MouaadO/analog-pwm-generator/pcb/BOM_PCB.csv

Reference | Value | Manufacturer part number | Footprint | LTspice reference | Description
R1 | 105 | MFR-25FBF52-105R | R_Axial_DIN0207_L6.3mm_D2.5mm_P7.62mm_Horizontal | RM1
R2 | 9.76 | MBA02040C9768FC100 | R_Axial_DIN0204_L3.6mm_D1.6mm_P5.08mm_Horizontal | RMH
R3 | 9.76 | MBA02040C9768FC100 | R_Axial_DIN0204_L3.6mm_D1.6mm_P5.08mm_Horizontal | RML
R4 | 105 | MFR-25FBF52-105R | R_Axial_DIN0207_L6.3mm_D2.5mm_P7.62mm_Horizontal | RM2
R5 | 12.3k | RNF14BTC12K3 | R_Axial_DIN0207_L6.3mm_D2.5mm_P7.62mm_Horizontal | RTIM
R6 | 1k | MFR-25FBF52-1K | R_Axial_DIN0207_L6.3mm_D2.5mm_P7.62mm_Horizontal | RH1
R7 | 12k | MFR-25FBF52-12K | R_Axial_DIN0207_L6.3mm_D2.5mm_P7.62mm_Horizontal | RH2
R8 | 1.8k | MFR-25FBF52-1K8 | R_Axial_DIN0207_L6.3mm_D2.5mm_P7.62mm_Horizontal | RPO
R9 | 9.76k | MFR-25FBF52-9K76 | R_Axial_DIN0207_L6.3mm_D2.5mm_P7.62mm_Horizontal | RCM1
R10 | 1k | MFR-25FBF52-1K | R_Axial_DIN0207_L6.3mm_D2.5mm_P7.62mm_Horizontal | RCM2
R11 | 1k | MFR-25FBF52-1K | R_Axial_DIN0207_L6.3mm_D2.5mm_P7.62mm_Horizontal | RL_C
R12 | 60.4k | MFR-25FRF52-60K4 | R_Axial_DIN0207_L6.3mm_D2.5mm_P7.62mm_Horizontal | RL_DT
R13 | 1k | MFR-25FBF52-1K | R_Axial_DIN0207_L6.3mm_D2.5mm_P7.62mm_Horizontal | RH_C
R14 | 60.4k | MFR-25FRF52-60K4 | R_Axial_DIN0207_L6.3mm_D2.5mm_P7.62mm_Horizontal | RH_DT
R15 | 1.8k | MFR-25FBF52-1K8 | R_Axial_DIN0207_L6.3mm_D2.5mm_P7.62mm_Horizontal | RPA
R16 | 1.8k | MFR-25FBF52-1K8 | R_Axial_DIN0207_L6.3mm_D2.5mm_P7.62mm_Horizontal | RPB
C1 | 22u/16V | MCGPR16V226M5X11 | CP_Radial_D5.0mm_P2.00mm | CIN
C2 | 4.7u/50V | EEU-FC1H4R7H | CP_Radial_D5.0mm_P2.50mm | COUT
C3 | 2.4n C0G 1% | C317C242F3G5TA | C317_5.08mm | CINT
C4 | 100n | K104K15X7RF5TL2 | Vishay_K15_P2.5mm | CU1
C5 | 100n | K104K15X7RF5TL2 | Vishay_K15_P2.5mm | CU2
C6 | 100n | K104K15X7RF5TL2 | Vishay_K15_P2.5mm | CU3
C7 | 100n | K104K15X7RF5TL2 | Vishay_K15_P2.5mm | CU5
U1 | TLC072CP | TLC072CP | DIP-8_W7.62mm | U1A/U1B
U2 | LM319N/NOPB | LM319N/NOPB | DIP-14_W7.62mm | OSC/PA
U3 | LM319N/NOPB | LM319N/NOPB | DIP-14_W7.62mm | PB/END_HIGH
U4 | LF50ABV | LF50ABV | TO-220-3_Vertical | REG
U5 | SN74ACT240N | SN74ACT240N | DIP-20_W7.62mm | U5A/U5C/U5D
D1 | BAT85S-TR | BAT85S-TR | D_DO-35_SOD27_P7.62mm_Horizontal | END_DIODE
RV1 | 1k DUTY | PTV09A-2020F-B102 | Bourns_PTV09A2_20mm | PD
RV2 | 50k FREQ | PTV09A-2015F-B503 | Bourns_PTV09A2 | PF
RV3 | Dual 1k DEAD TIME | PTN16-A01220K1B2 | SameSky_PTN16_A_Dual | PDT_L/PDT_H
J1 | 7-10V DC, CENTRE + | PJ-102AH | BarrelJack_CUI_PJ-102AH_Horizontal | VINPUT | DC input included in current purchasing BOM; 7-10 V, centre positive
J2 | EXTERNAL DUTY | BU-1420701236 | Mueller_BU1420701236 | VEXT
J3 | MANUAL / EXTERNAL | PPTC031LFBN-RC | PinSocket_1x03_P2.54mm_Vertical | JSEL | Male jumper wire 1-2 manual, 2-3 external
J4 | DIGITAL 10 / OUT | PPTC101LFBN-RC | PinSocket_1x10_P2.54mm_Vertical | JHDR10 | UNO order SCL,SDA,AREF,GND,D13,D12,D11,D10,D9,D8
J5 | DIGITAL 8 | PPTC081LFBN-RC | PinSocket_1x08_P2.54mm_Vertical | JHDR8A | UNO D7..D0; unused
J6 | POWER | PPTC081LFBN-RC | PinSocket_1x08_P2.54mm_Vertical | JHDR8B | UNO order NC,IOREF,RESET,3V3,5V,GND,GND,VIN; no USB/Arduino backfeed protection
J7 | ANALOG 6 | PPTC061LFBN-RC | PinSocket_1x06_P2.54mm_Vertical | JHDR6 | UNO A0..A5; unused
