MouaadO/analog-pwm-generator/upload_002.xlsx

Sheet: Components
ANALOG PWM · COMPONENT PURCHASE COSTS
French VAT | 20% |  | TOTAL INCLUDING TAX |  | €31.81
Component type | Supplier part number | Component part number | Unit price (including tax) | Quantity | Total price (including tax) | Online retailer
Dual op amp · DIP-8 | 3005151 | TLC072CP | €3.6240 | 1 | €3.62 | Farnell ↗ (https://fr.farnell.com/texas-instruments/tlc072cp/ic-op-amp-hi-speed-rrio/dp/3005151)
Dual comparator · DIP-14 | LM319NNS/NOPB-ND | LM319N/NOPB | €2.6400 | 2 | €5.28 | DigiKey ↗ (https://www.digikey.fr/fr/products/detail/texas-instruments/LM319N-NOPB/9551)
Octal inverter · DIP-20 | 595-SN74ACT240N | SN74ACT240N | €1.7160 | 1 | €1.72 | Mouser ↗ (https://www.mouser.fr/en/ProductDetail/Texas-Instruments/SN74ACT240N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)
5 V LDO · ±1% at 25°C · TO-220 | 3130160 | LF50ABV | €1.3440 | 1 | €1.34 | Farnell ↗ (https://fr.farnell.com/stmicroelectronics/lf50abv/ldo-fixe-5v-0-5a-40-a-125-c/dp/3130160)
105 Ω resistor · 1% · 0.25 W axial | 603-MFR-25FBF52-105R | MFR-25FBF52-105R | €0.1032 | 2 | €0.21 | Mouser ↗ (https://www.mouser.fr/fr/ProductDetail/YAGEO/MFR-25FBF52-105R?qs=oAGoVhmvjhx1xjvQjhBaqA%3D%3D)
9.76 Ω resistor · 1% · axial | 594-5063JD9.761% | MBA02040C9768FC100 | €1.0944 | 2 | €2.19 | Mouser ↗ (https://www.mouser.fr/en/ProductDetail/Vishay-Beyschlag/MBA02040C9768FC100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)
12.3 kΩ resistor · 0.1% · 0.25 W axial | 708-RNF14BTC12K3 | RNF14BTC12K3 | €0.1656 | 1 | €0.17 | Mouser ↗ (https://www.mouser.fr/en/ProductDetail/SEI-Stackpole/RNF14BTC12K3?qs=LnCj936TGbUaYoq1Wc%2FTVQ%3D%3D)
1 kΩ resistor · 1% · 0.25 W axial | 603-MFR-25FBF52-1K | MFR-25FBF52-1K | €0.1032 | 4 | €0.41 | Mouser ↗ (https://www.mouser.fr/fr/ProductDetail/YAGEO/MFR-25FBF52-1K?qs=oAGoVhmvjhwCAC47ReWjsQ%3D%3D)
12 kΩ resistor · 1% · 0.25 W axial | MFR-25FBF52-12K-ND | MFR-25FBF52-12K | €0.1080 | 1 | €0.11 | DigiKey ↗ (https://www.digikey.fr/en/products/detail/yageo/MFR-25FBF52-12K/9138051)
1.8 kΩ resistor · 1% · 0.25 W axial | 603-MFR-25FBF52-1K8 | MFR-25FBF52-1K8 | €0.1032 | 3 | €0.31 | Mouser ↗ (https://www.mouser.fr/ProductDetail/YAGEO/MFR-25FBF52-1K8?qs=oAGoVhmvjhxFlUUkv6aTEg%3D%3D)
9.76 kΩ resistor · 1% · 0.25 W axial | 9.76KXBK-ND | MFR-25FBF52-9K76 | €0.1080 | 1 | €0.11 | DigiKey ↗ (https://www.digikey.fr/en/products/detail/yageo/MFR-25FBF52-9K76/13217)
60.4 kΩ resistor · 1% · 0.25 W axial | 603-MFR-25FRF52-60K4 | MFR-25FRF52-60K4 | €0.1080 | 2 | €0.22 | Mouser ↗ (https://www.mouser.fr/fr/ProductDetail/YAGEO/MFR-25FRF52-60K4?qs=oAGoVhmvjhwuEJuU8%2FmJxQ%3D%3D)
22 µF capacitor · 16 V · 20% radial | 9451064 | MCGPR16V226M5X11 | €0.1158 | 1 | €0.12 | Farnell ↗ (https://fr.farnell.com/multicomp-pro/mcgpr16v226m5x11/cap-22-f-16v-20/dp/9451064)
100 nF capacitor · 50 V · X7R · 10% radial | 2860097 | K104K15X7RF5TL2 | €0.1126 | 10 | €1.13 | Farnell ↗ (https://fr.farnell.com/en-FR/vishay/k104k15x7rf5tl2/cap-0-1-f-50v-10-x7r/dp/2860097)
2.4 nF capacitor · 25 V · C0G · 1% radial | 80-C317C242F3G5TA | C317C242F3G5TA | €1.8000 | 1 | €1.80 | Mouser ↗ (https://www.mouser.fr/fr/ProductDetail/KEMET/C317C242F3G5TA)
50 kΩ linear potentiometer · single gang | 652-PTV09A-2015FB503 | PTV09A-2015F-B503 | €1.1664 | 1 | €1.17 | Mouser ↗ (https://www.mouser.fr/fr/ProductDetail/Bourns/PTV09A-2015F-B503)
1 kΩ linear potentiometer · single gang | 652-PTV09A-4225FB102 | PTV09A-4225F-B102 | €0.9180 | 1 | €0.92 | Mouser ↗ (https://www.mouser.fr/ProductDetail/Bourns/PTV09A-4225F-B102?qs=Qzws7J6gxqyeFhc0kO3Q7A%3D%3D)
1 kΩ linear potentiometer · dual gang | 179-PTN16-A01220K1B2 | PTN16-A01220K1B2 | €1.8720 | 1 | €1.87 | Mouser ↗ (https://www.mouser.fr/en/ProductDetail/Same-Sky/PTN16-A01220K1B2?qs=VJzv269c%252BPaiDuqAWK2%252BFA%3D%3D)
Schottky diode · 30 V · DO-35 axial | BAT85SCT-ND | BAT85S-TR | €0.5280 | 1 | €0.53 | DigiKey ↗ (https://www.digikey.fr/en/products/detail/vishay-general-semiconductor-diodes-division/BAT85S-TR/3104128)
3-pin selector header · 2.54 mm THT | 952-2263-ND | M20-9990345 | €0.1560 | 1 | €0.16 | DigiKey ↗ (https://www.digikey.fr/fr/products/detail/harwin-inc/M20-9990345/3728227)
2-pin selector shunt · 2.54 mm | 952-2881-ND | M7582-05 | €0.1680 | 1 | €0.17 | DigiKey ↗ (https://www.digikey.fr/en/products/detail/harwin-inc/M7582-05/3922850)
Female SMA jack · vertical THT | 4472531 | BU-1420701236 | €5.4360 | 1 | €5.44 | Farnell ↗ (https://fr.farnell.com/mueller-electric/bu-1420701236/conn-rf-sma-fem-50-ohms-pcb/dp/4472531)
4.7 µF capacitor · 50 V · 20% radial | P19662CT-ND | EEU-FC1H4R7H | €0.4320 | 1 | €0.43 | DigiKey ↗ (https://www.digikey.fr/en/products/detail/panasonic-industry/EEU-FC1H4R7H/6109560)
6-pin female header · 2.54 mm THT | S7004-ND | PPTC061LFBN-RC | €0.4920 | 1 | €0.49 | DigiKey ↗ (https://www.digikey.fr/fr/products/detail/sullins-connector-solutions/PPTC061LFBN-RC/810145)
8-pin female header · 2.54 mm THT | S7006-ND | PPTC081LFBN-RC | €0.6120 | 2 | €1.22 | DigiKey ↗ (https://www.digikey.fr/fr/products/detail/sullins-connector-solutions/PPTC081LFBN-RC/810147)
10-pin female header · 2.54 mm THT | S7008-ND | PPTC101LFBN-RC | €0.6720 | 1 | €0.67 | DigiKey ↗ (https://www.digikey.fr/fr/products/detail/sullins-connector-solutions/PPTC101LFBN-RC/810149)

Sheet: Prices
SUPPLIER QUOTATIONS · BEFORE TAX INPUTS
Component part number | Supplier part number | Unit € before tax | Retailer | Quote source | Fitted quantity | Purchase quantity | Schematic references
TLC072CP | 3005151 | €3.0200 | Farnell | Source ↗ (https://fr.farnell.com/c/semiconducteurs-circuits-integres/amplificateurs-comparateurs/amplificateurs-operationnels-aop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) | 1 | 1 | U1A, U1B
LM319N/NOPB | LM319NNS/NOPB-ND | €2.2000 | DigiKey | Source ↗ (https://www.digikey.fr/fr/products/detail/texas-instruments/LM319N-NOPB/9551) | 2 | 2 | OSC, PA; PB, END_HIGH
SN74ACT240N | 595-SN74ACT240N | €1.4300 | Mouser | Source ↗ (https://www.mouser.ie/en/ProductDetail/Texas-Instruments/SN74ACT240N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) | 1 | 1 | U5A, U5C, U5D
LF50ABV | 3130160 | €1.1200 | Farnell | Source ↗ (https://fr.farnell.com/stmicroelectronics/lf50abv/ldo-fixe-5v-0-5a-40-a-125-c/dp/3130160) | 1 | 1 | REG
MFR-25FBF52-105R | 603-MFR-25FBF52-105R | €0.0860 | Mouser | Source ↗ (https://www.mouser.fr/fr/ProductDetail/YAGEO/MFR-25FBF52-105R?qs=oAGoVhmvjhx1xjvQjhBaqA%3D%3D) | 2 | 2 | RM1, RM2
MBA02040C9768FC100 | 594-5063JD9.761% | €0.9120 | Mouser | Source ↗ (https://www.mouser.fr/en/c/passive-components/resistors/?resistance=9.76%20Ohms) | 2 | 2 | RMH, RML
RNF14BTC12K3 | 708-RNF14BTC12K3 | €0.1380 | Mouser | Source ↗ (https://www.mouser.fr/en/ProductDetail/SEI-Stackpole/RNF14BTC12K3?qs=LnCj936TGbUaYoq1Wc%2FTVQ%3D%3D) | 1 | 1 | RTIM
MFR-25FBF52-1K | 603-MFR-25FBF52-1K | €0.0860 | Mouser | Source ↗ (https://www.mouser.fr/fr/ProductDetail/YAGEO/MFR-25FBF52-1K?qs=oAGoVhmvjhwCAC47ReWjsQ%3D%3D) | 4 | 4 | RH1, RCM2, RL_C, RH_C
MFR-25FBF52-12K | MFR-25FBF52-12K-ND | €0.0900 | DigiKey | Source ↗ (https://www.digikey.fr/en/products/detail/yageo/MFR-25FBF52-12K/9138051) | 1 | 1 | RH2
MFR-25FBF52-1K8 | 603-MFR-25FBF52-1K8 | €0.0860 | Mouser | Source ↗ (https://www.mouser.fr/ProductDetail/YAGEO/MFR-25FBF52-1K8?qs=oAGoVhmvjhxFlUUkv6aTEg%3D%3D) | 3 | 3 | RPO, RPA, RPB
MFR-25FBF52-9K76 | 9.76KXBK-ND | €0.0900 | DigiKey | Source ↗ (https://www.digikey.fr/en/products/detail/yageo/MFR-25FBF52-9K76/13217) | 1 | 1 | RCM1
MFR-25FRF52-60K4 | 603-MFR-25FRF52-60K4 | €0.0900 | Mouser | Source ↗ (https://www.mouser.fr/fr/ProductDetail/YAGEO/MFR-25FRF52-60K4?qs=oAGoVhmvjhwuEJuU8%2FmJxQ%3D%3D) | 2 | 2 | RL_DT, RH_DT
MCGPR16V226M5X11 | 9451064 | €0.0965 | Farnell | Source ↗ (https://fr.farnell.com/multicomp-pro/mcgpr16v226m5x11/cap-22-f-16v-20/dp/9451064) | 1 | 1 | CIN
K104K15X7RF5TL2 | 2860097 | €0.0938 | Farnell | Source ↗ (https://fr.farnell.com/en-FR/vishay/k104k15x7rf5tl2/cap-0-1-f-50v-10-x7r/dp/2860097) | 4 | 10 | CU1, CU2, CU3, CU5
C317C242F3G5TA | 80-C317C242F3G5TA | €1.5000 | Mouser | Source ↗ (https://www.mouser.fr/fr/ProductDetail/KEMET/C317C242F3G5TA) | 1 | 1 | CINT
PTV09A-2015F-B503 | 652-PTV09A-2015FB503 | €0.9720 | Mouser | Source ↗ (https://www.mouser.fr/fr/ProductDetail/Bourns/PTV09A-2015F-B503) | 1 | 1 | PF
PTV09A-4225F-B102 | 652-PTV09A-4225FB102 | €0.7650 | Mouser | Source ↗ (https://nl.mouser.com/ProductDetail/Bourns/PTV09A-4225F-B102?qs=Qzws7J6gxqyeFhc0kO3Q7A%3D%3D) | 1 | 1 | PD
PTN16-A01220K1B2 | 179-PTN16-A01220K1B2 | €1.5600 | Mouser | Source ↗ (https://www.mouser.fr/en/ProductDetail/Same-Sky/PTN16-A01220K1B2?qs=VJzv269c%252BPaiDuqAWK2%252BFA%3D%3D) | 1 | 1 | PDT_H, PDT_L
BAT85S-TR | BAT85SCT-ND | €0.4400 | DigiKey | Source ↗ (https://www.digikey.fr/en/products/detail/vishay-general-semiconductor-diodes-division/BAT85S-TR/3104128) | 1 | 1 | END_DIODE
M20-9990345 | 952-2263-ND | €0.1300 | DigiKey | Source ↗ (https://www.digikey.fr/fr/products/detail/harwin-inc/M20-9990345/3728227) | 1 | 1 | JSEL selector header
M7582-05 | 952-2881-ND | €0.1400 | DigiKey | Source ↗ (https://www.digikey.fr/en/products/detail/harwin-inc/M7582-05/3922850) | 1 | 1 | JSEL shunt
BU-1420701236 | 4472531 | €4.5300 | Farnell | Source ↗ (https://fr.farnell.com/mueller-electric/bu-1420701236/conn-rf-sma-fem-50-ohms-pcb/dp/4472531) | 1 | 1 | JSMA: external VD / GND
EEU-FC1H4R7H | P19662CT-ND | €0.3600 | DigiKey | Source ↗ (https://www.digikey.fr/en/products/detail/panasonic-industry/EEU-FC1H4R7H/6109560) | 1 | 1 | COUT (replaces 100 nF)
PPTC061LFBN-RC | S7004-ND | €0.4100 | DigiKey | Source ↗ (https://www.digikey.fr/fr/products/detail/sullins-connector-solutions/PPTC061LFBN-RC/810145) | 1 | 1 | JHDR6
PPTC081LFBN-RC | S7006-ND | €0.5100 | DigiKey | Source ↗ (https://www.digikey.fr/fr/products/detail/sullins-connector-solutions/PPTC081LFBN-RC/810147) | 2 | 2 | JHDR8A, JHDR8B
PPTC101LFBN-RC | S7008-ND | €0.5600 | DigiKey | Source ↗ (https://www.digikey.fr/fr/products/detail/sullins-connector-solutions/PPTC101LFBN-RC/810149) | 1 | 1 | JHDR10
