MouaadO/analog-pwm-generator/pcb/3dmodels/PTN16-A01220K1B2_Manufacturer_Aligned_Original.step

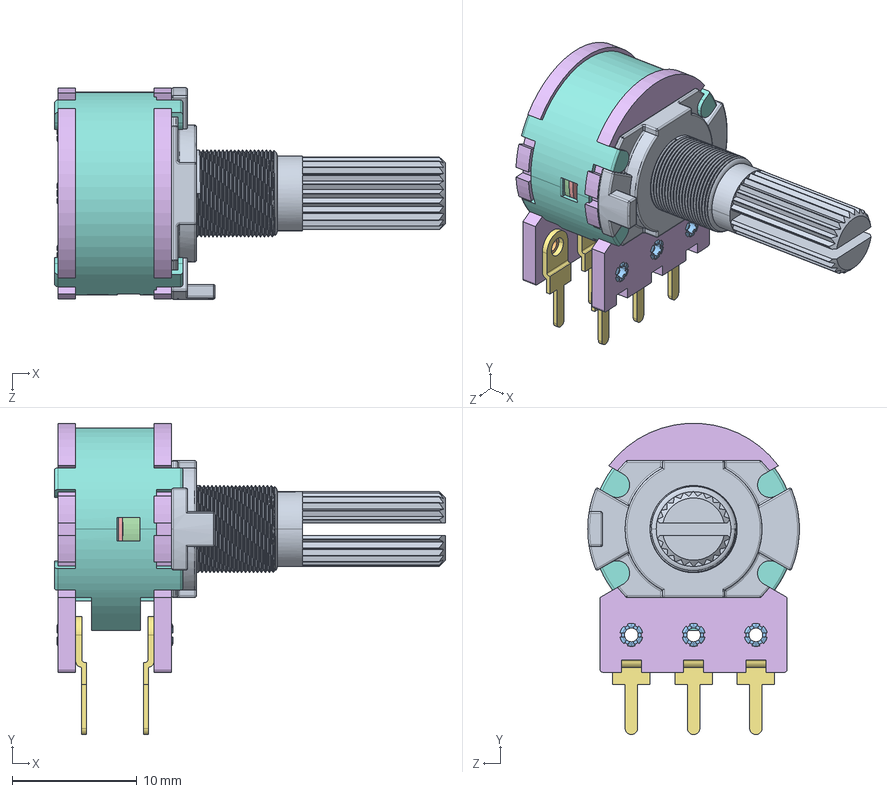
[picture p8: CAD file, 2026-11-05]
pcb/3dmodels/PTN16-A01220K1B2_Manufacturer_Aligned_Original.step
31.4 x 25.0 x 17.0 mm
PTN16_2 BUSHING
PTN16-A_2 HOUSING
PTN16_20K1_SHAFT
