MouaadO/analog-pwm-generator/pcb/3dmodels/PJ-102AH_Manufacturer_Aligned.step

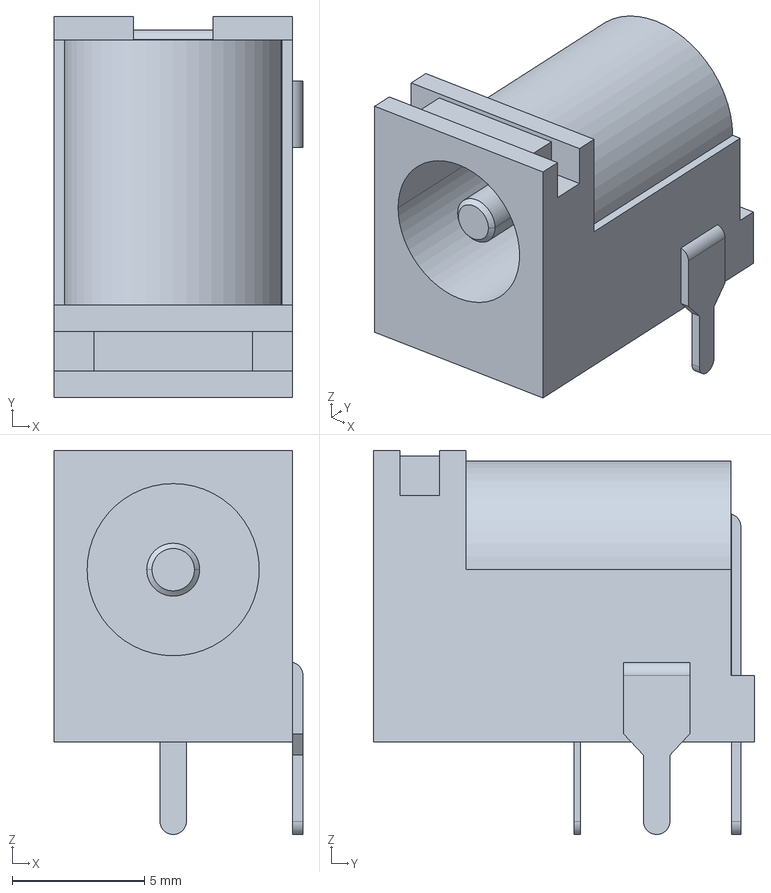
[picture p9: CAD file, 2026-10-21]
pcb/3dmodels/PJ-102AH_Manufacturer_Aligned.step
9.40 x 14.4 x 14.5 mm
