MouaadO/analog-pwm-generator/(list of files, cad)

Other CAD files:
pcb/3dmodels/PTN16-A01220K1B2_Manufacturer_Aligned.step
