MouaadO/analog-pwm-generator/upload_034.asc

CIN: PWM_CV; 22u; Rser=.3
CINT: PWM_CH; 2.4n
CLA: PWM_CV; 50p
CLB: PWM_CV; 50p
COUT: PWM_CV; 100n
CU1: PWM_CV; 100n
CU2: PWM_CV; 100n
CU3: PWM_CV; 100n
CU5: PWM_CV; 100n
END_DIODE: PWM_DX; BAT85
END_HIGH: PWM_CMP; LM319_SECTION
JSEL: PWM_JUMP; SELECT
OSC: PWM_CMP; LM319_SECTION
PA: PWM_CMP; LM319_SECTION
PB: PWM_CMP; LM319_SECTION
PD: PWM_POT; DUTY
PDT_H: PWM_POT; DT_HIGH
PDT_L: PWM_POT; DT_LOW
PF: PWM_POT; FREQ_A
RCM1: PWM_RH; 9.76k
RCM2: PWM_RV; 1k
REG: PWM_REG; L7805_TRIAL
RH1: PWM_RH; 1k
RH2: PWM_RV; 12k
RH_C: PWM_RH; 1k
RH_DT: PWM_RH; 60.4k
RL_C: PWM_RH; 1k
RL_DT: PWM_RH; 60.4k
RLA: PWM_RV; {if(LOAD,180,1T)}
RLB: PWM_RV; {if(LOAD,180,1T)}
RM1: PWM_RV; 105
RM2: PWM_RV; 105
RMH: PWM_RV; 9.76
RML: PWM_RV; 9.76
RPA: PWM_RV; 1.8k
RPB: PWM_RV; 1.8k
RPO: PWM_RV; 1.8k
RSA: PWM_RV; {if(LOAD,180,1T)}
RSB: PWM_RV; {if(LOAD,180,1T)}
RTIM: PWM_RH; 12.3k
U1A: PWM_AMP; TLC072CP
U1B: PWM_AMP; TLC072CP
U5A: PWM_INV; ACT240_INV
U5C: PWM_INV; ACT240_3INV
U5D: PWM_INV; ACT240_3INV
VEXT: PWM_V; {VD}
VINPUT: PWM_V; PWL(0 0 10u {VIN})
Named nets: 0, VIN, V5, VM, TRI, CLOCK, COMMAND, LOW, HIGH, DT_HIGH, DT_LOW, CMD, END_HIGH, END_LOW, FORCE_LOW, PA, PB, OUT1, OUT2
PWM7805 33 - ORDINARY 1% REFERENCE DIVIDER; shared duty and direct dead-time thresholds
33 PCB positions:16 fixed R +7 C +5 IC packages +1 diode +3 pot bodies +1 selector header. Test loads/connectors excluded.
5 V / PASSIVE MIDPOINT AND ENDPOINT LIMITS
TRIANGLE / FREQUENCY POT
DUTY INPUT / SHARED CMD
ONE DUAL-GANG DEAD-TIME POT
LOW THRESHOLD / OUT1
HIGH THRESHOLD / OUT2
ENDPOINT HANDLING USING EXISTING IC SECTIONS
LOCAL BYPASS
SEPARATE TRIAL: the original PWM7805 is unchanged. The endpoint limits follow the actual regulator rail; fixed5V accuracy across rail tolerances is not qualified.
U1A is the LOWER endpoint detector, reusing the former midpoint buffer. U1B remains the triangle integrator. ONE TLC072CP DIP8.
OSC+PA are ONE LM319N DIP14. PB+END_HIGH are the SECOND LM319N DIP14; all four comparator sections now used.
END_HIGH collector shares PA directly: upper endpoint forces OUT1 high. BAT85 anodePB/cathodeFORCE_LOW: lower endpoint forces OUT2 high.
U5A/C/D:ONE SN74ACT240N DIP20. Clock input2/output18. OUT1 inputs6/8/11, outputs14/12/9 in parallel.
OUT2 inputs13/15/17, outputs7/5/3 in parallel. Spare input4=GND/output16 open. OE1/OE19=GND,VCC20=V5,GND10=0.
CMD mixes COMMAND andVM. LOW/HIGH mix CMD with opposed dead-pot tracks. TRI<LOW:OUT1 high; LOW<TRI<HIGH:both low; TRI>HIGH:OUT2 high.
This trims both edges. Ideal duties D-d and1-D-d, clipped; small pulses may vanish. It differs from the original rising-edge-only delay.
PF:ONE single-gang50k linear frequency pot. PDT_H/L:ONE dual-gang1k dead pot. PD:ONE single-gang1k duty pot. No resistor arrays.
REG:L7805CV TO220 pin1=IN,pin2=GND/tab,pin3=OUT. RM1/RM2=105ohm 1%; RMH/RML=9.76ohm 1%. Ladder draws about21.8mA. No added parts; all fixed resistors may be ordinary1%.
Nominal models only: original TI amplifier family/ST comparator/Nexperia BAT85 models. ACT240/regulator functional assumptions retained. No full hardware/PVT or PCB-fit certification.
Endpoint guard band widened to tolerate1% reference/duty resistors; outputs clamp earlier near0/5V. Op-amp saturation recovery and comparator offsets need bench checks. External command checked only near-0.1..5.1V.
SOURCE1=external VD,SOURCE0=DP pot. FP0~20kHz/FP1~100kHz. DTP0..1~0..10%T. The maximum gap is approximate and frequency-dependent propagation remains.
One transient:probe TRI,CMD,LOW,HIGH,OUT1,OUT2 directly. No saved plots. RLA/RSA/RLB/RSB and CLA/CLB are simulator test loads, not PCB parts.
.include TLC074_TI.lib
.include LM319_ST.lib
.include L7805_Functional.lib
.include ACT240_Functional.lib
.include Symmetric_Parts.lib
.include BAT85_Nexperia.lib
.param FP=1 DP=.5 DTP=1 SOURCE=1 VD=2.5 VIN=8.5 LOAD=1 DRV_CORNER=0 REG_VSET=5 REG_DROP=2
.options plotwinsize=0 threads=1 method=gear reltol=.003 solver=normal gmin=1e-9 abstol=1e-9 vntol=1e-5
.tran 0 600u 0 20n uic
1% DIVIDER REVISION - only RM1/RM2 changed100->105ohm. Original file preserved. Other model/transition limits remain.
PRE-EXISTING LIMITS:command-step overlap, zero-DT transitions and fixed5V external-input accuracy over regulator corners remain unqualified.
