MouaadO/analog-pwm-generator/(list of files, drawings)

Other design files:
docs/results/PCB_DRC_Report.json
docs/results/Schematic_ERC_Report.json
