MouaadO/analog-pwm-generator/pcb/Analog_PWM.kicad_pcb

## KiCad design pcb/Analog_PWM.kicad_pcb (2026-11-05)

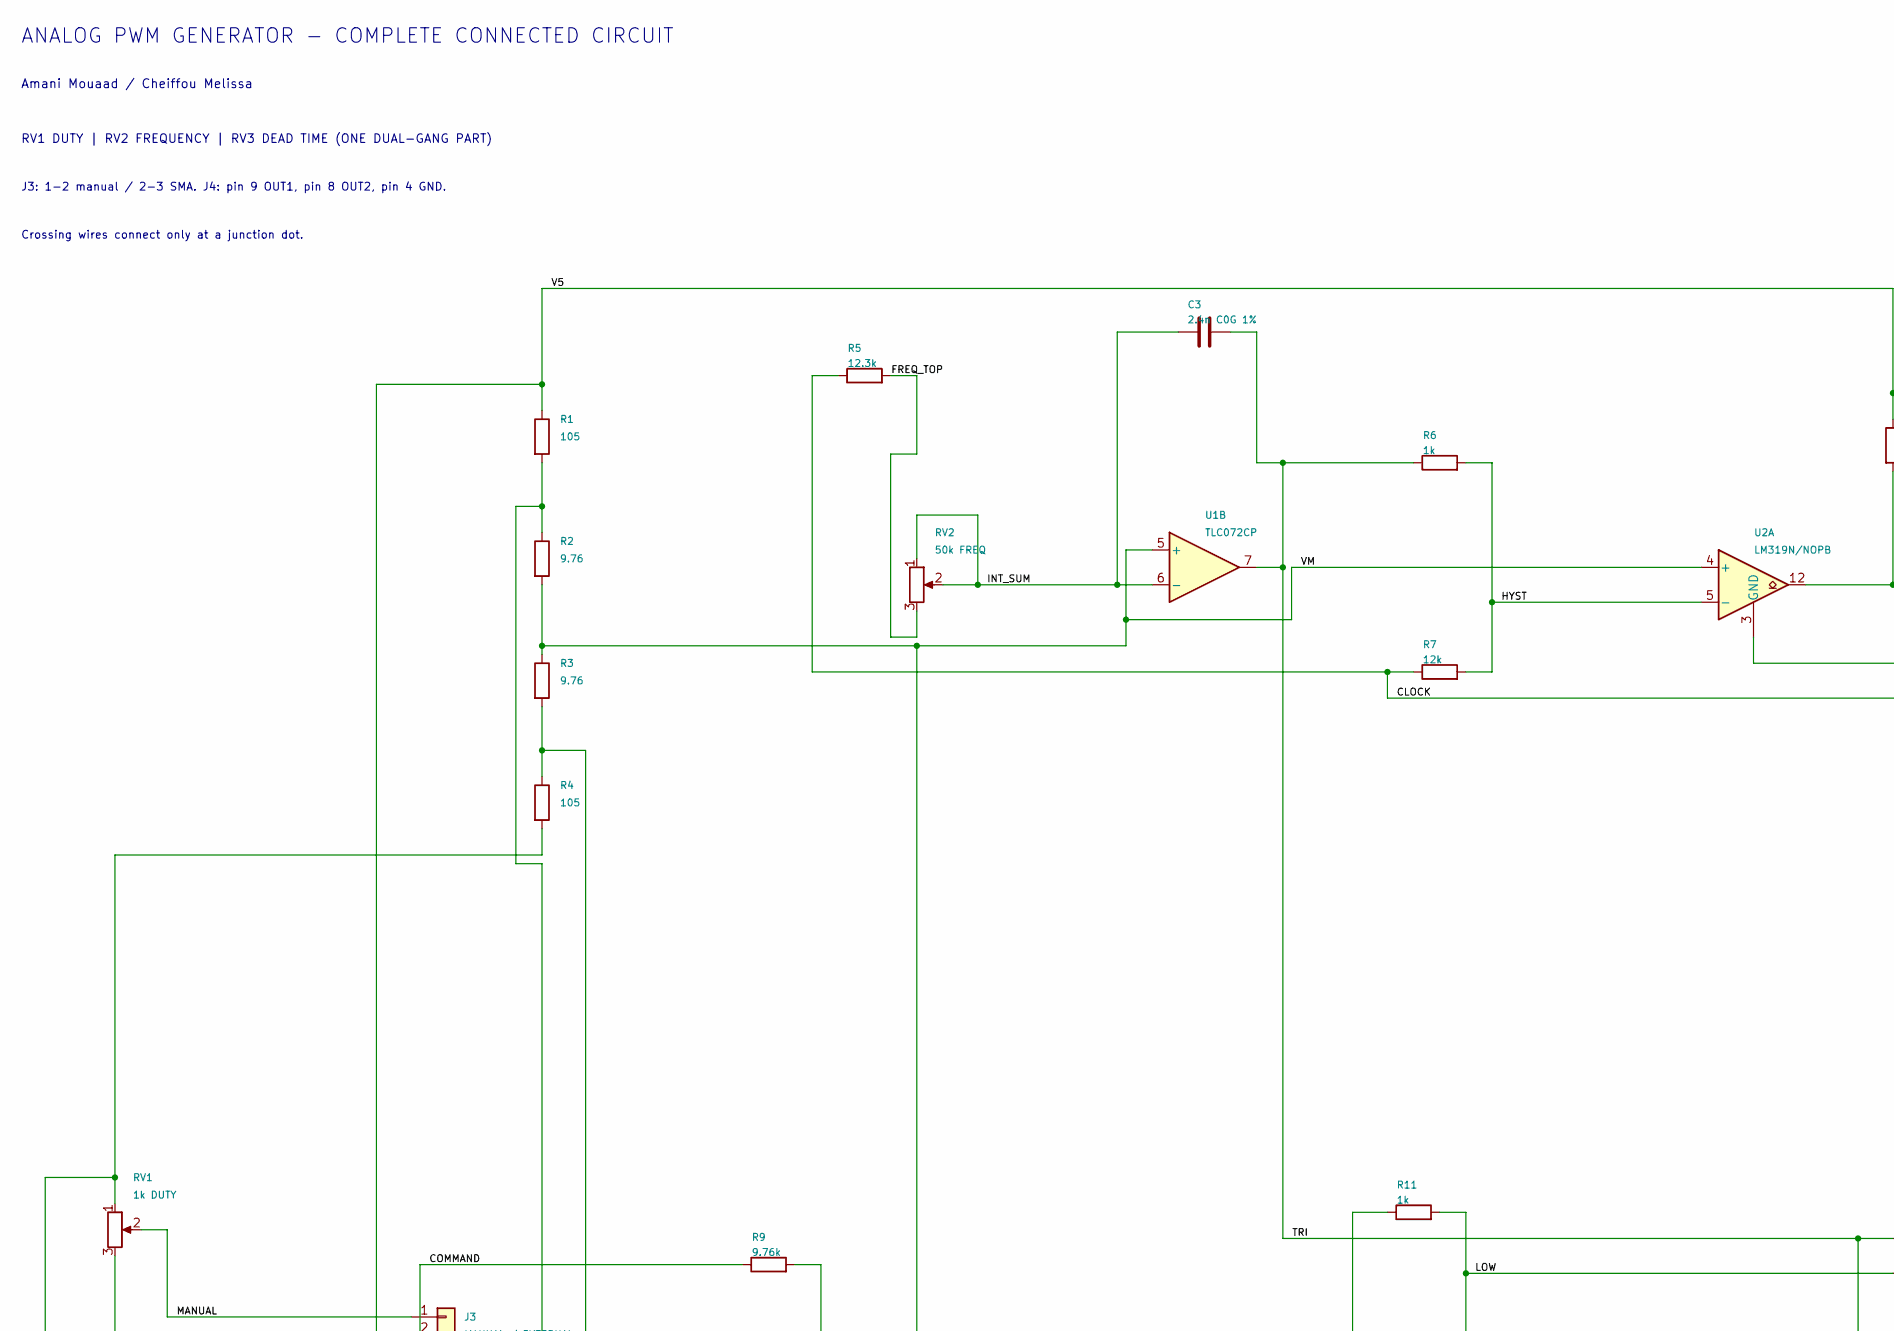
[picture p10: schematic Analog_PWM.kicad_sch, Analog PWM generator, part in row 1, column 1]

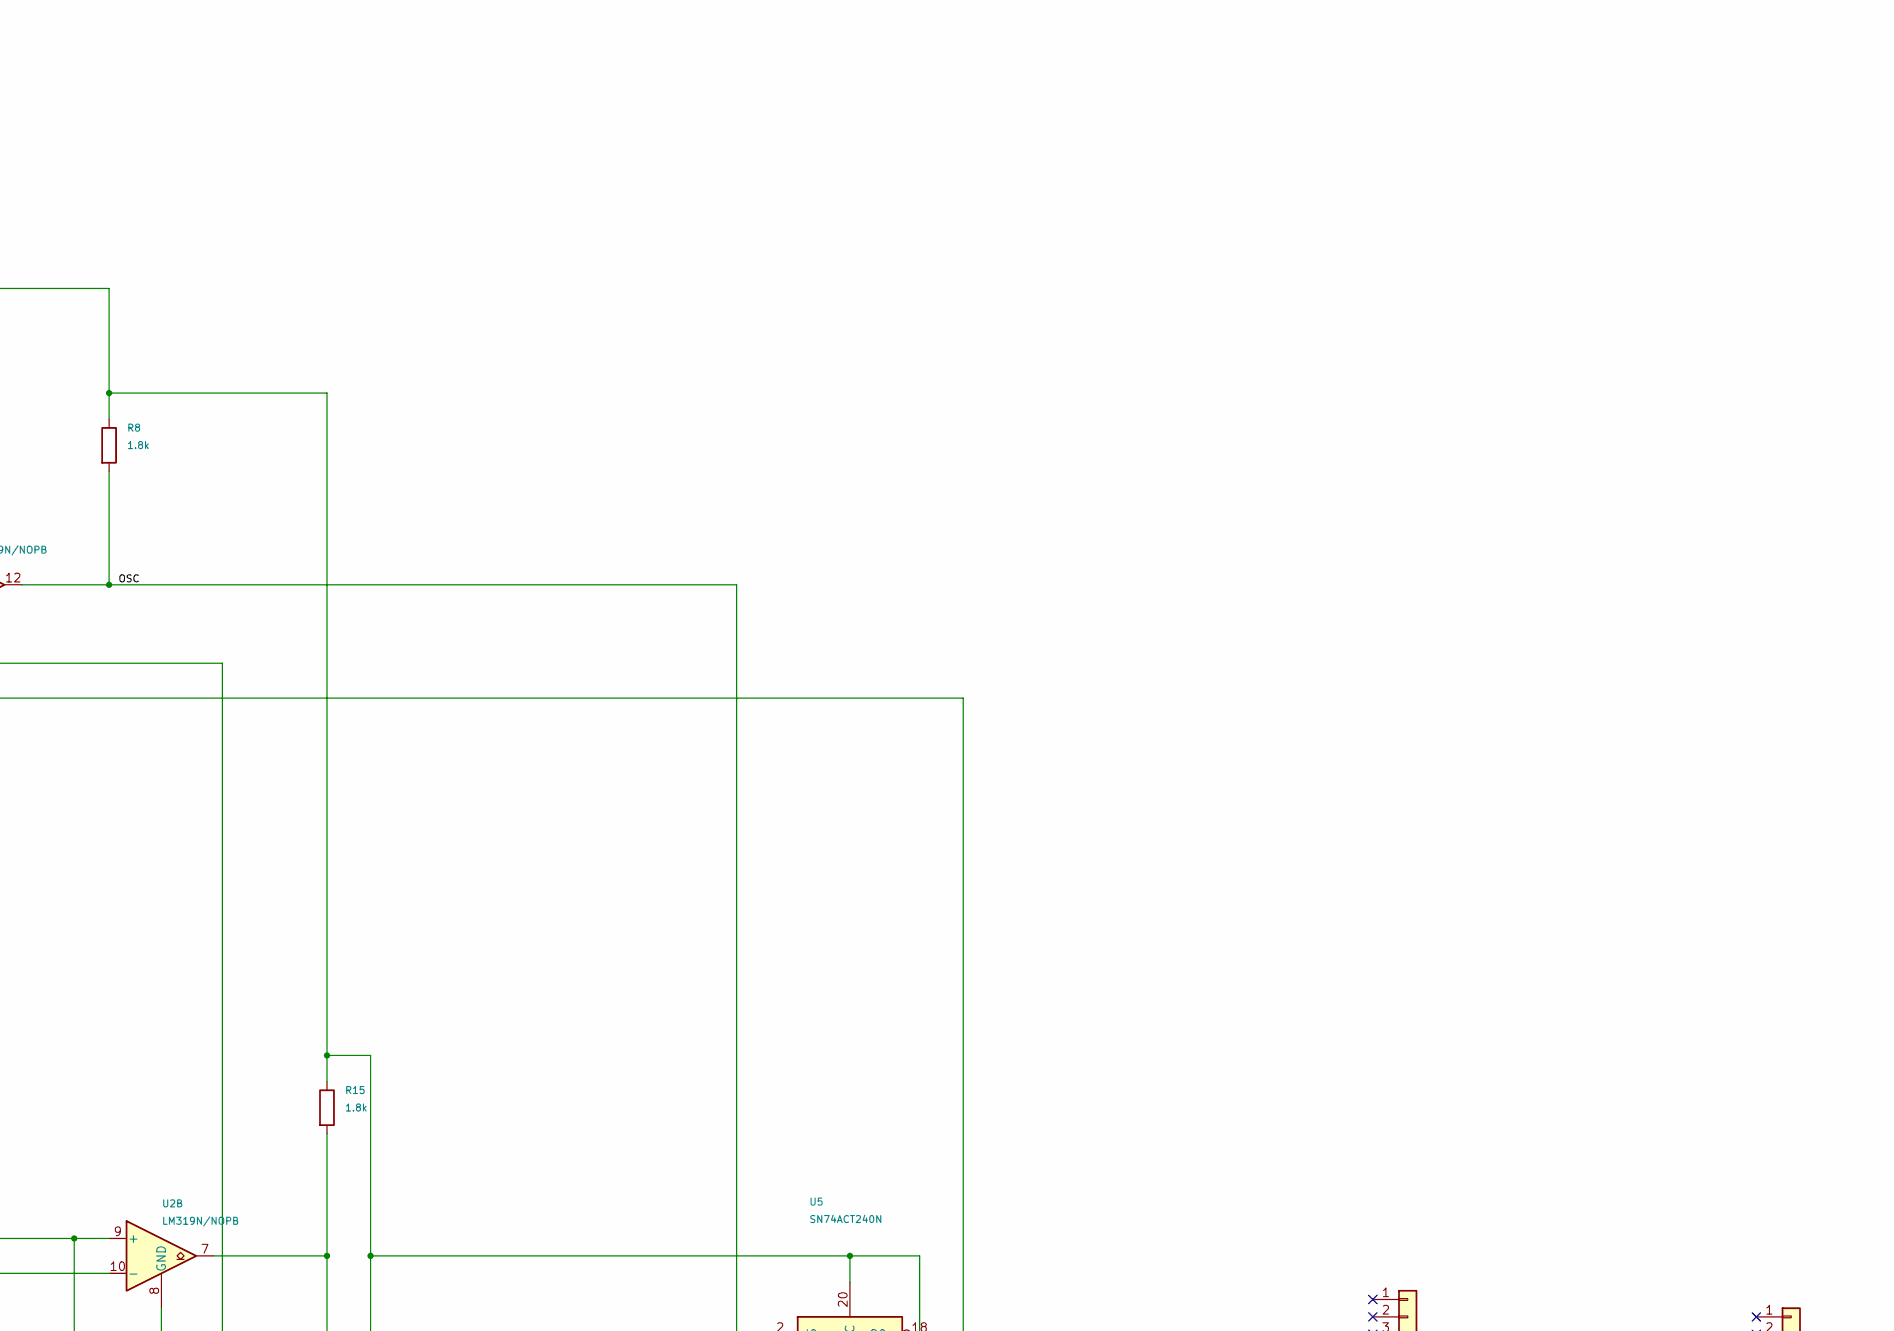
[picture p11: schematic Analog_PWM.kicad_sch, Analog PWM generator, part in row 1, column 2]

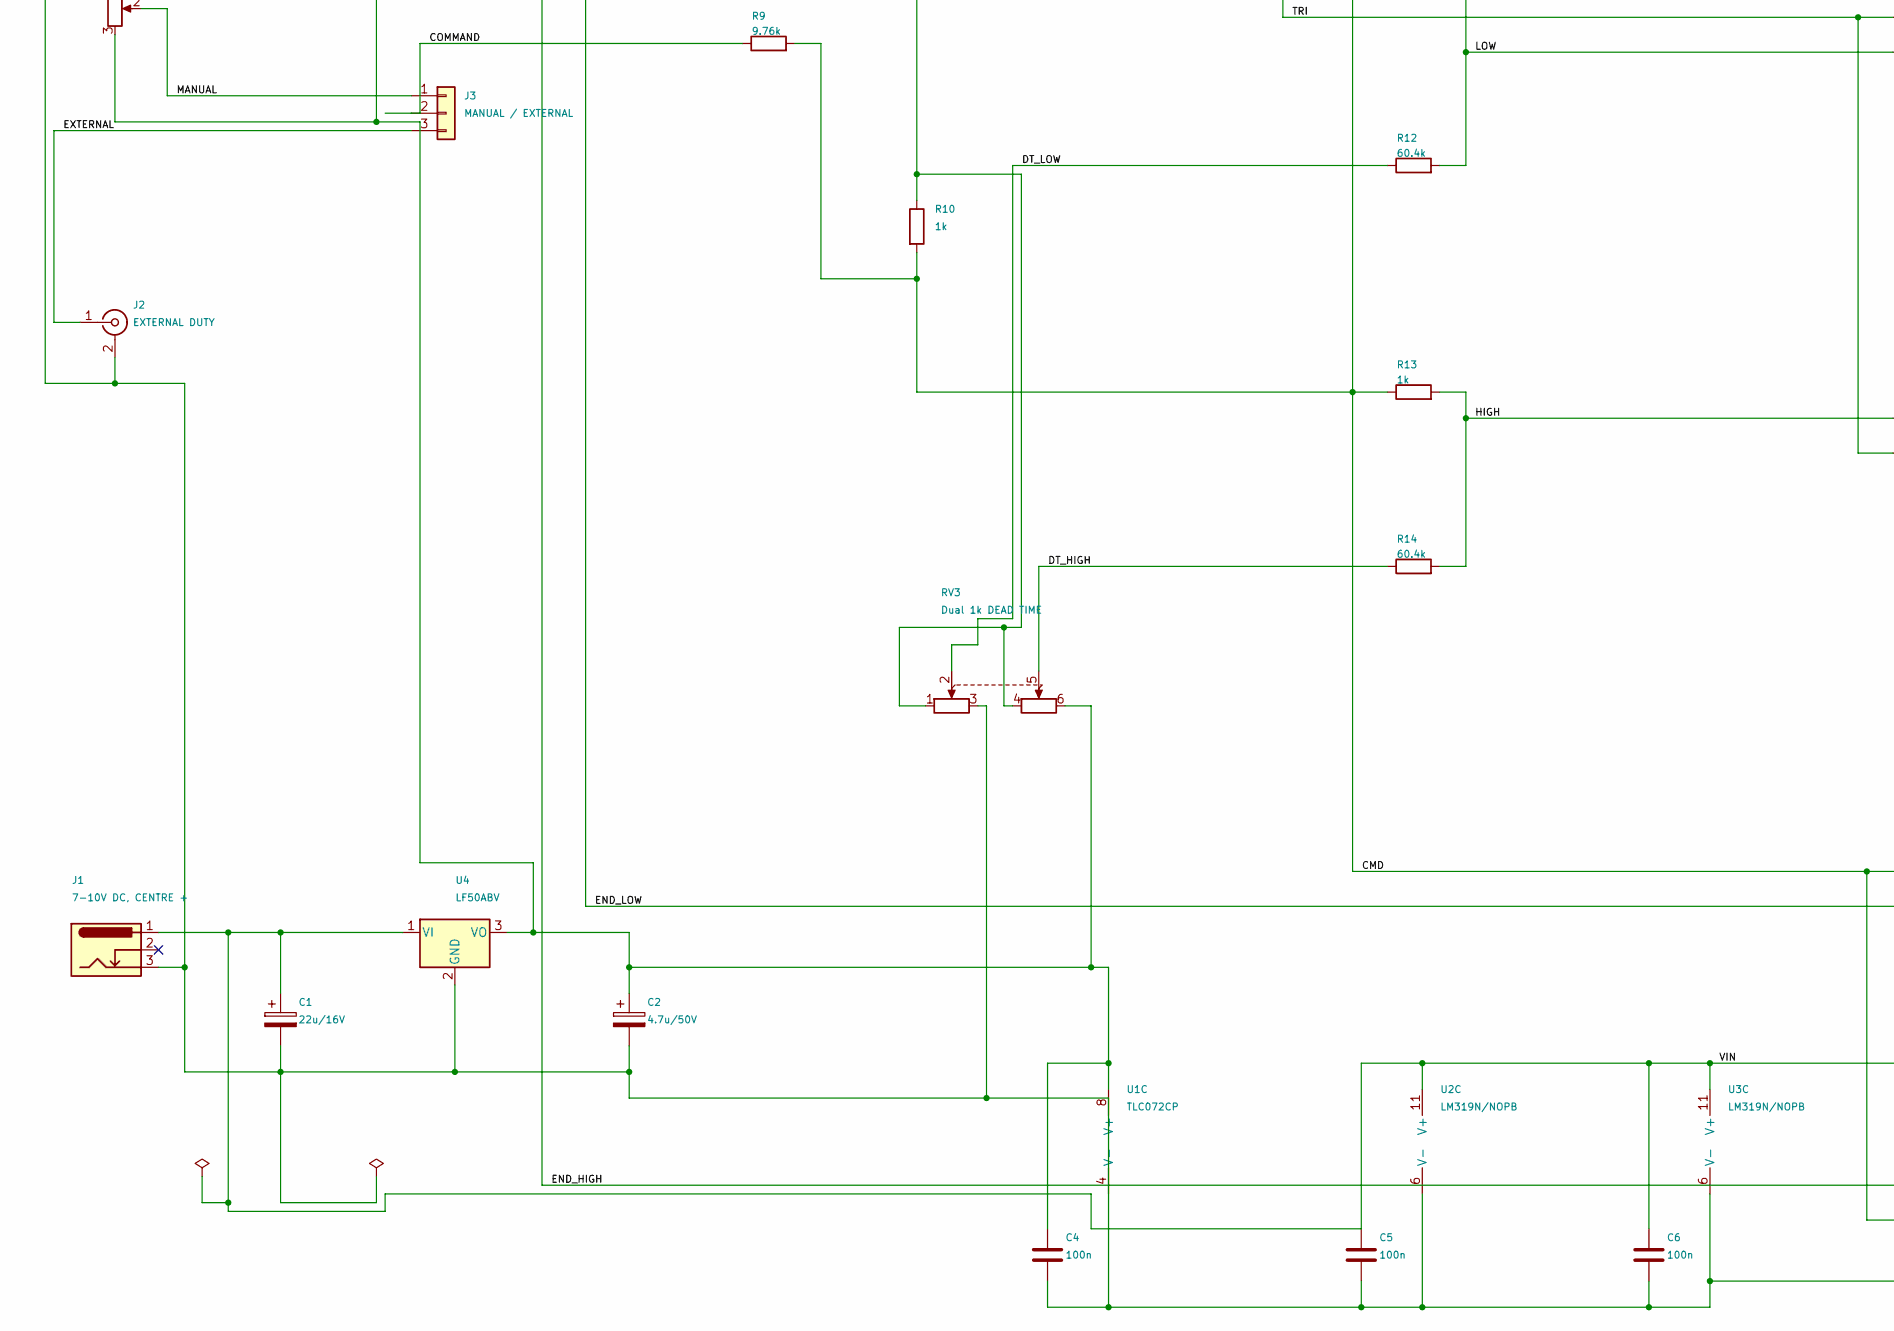
[picture p12: schematic Analog_PWM.kicad_sch, Analog PWM generator, part in row 2, column 1]

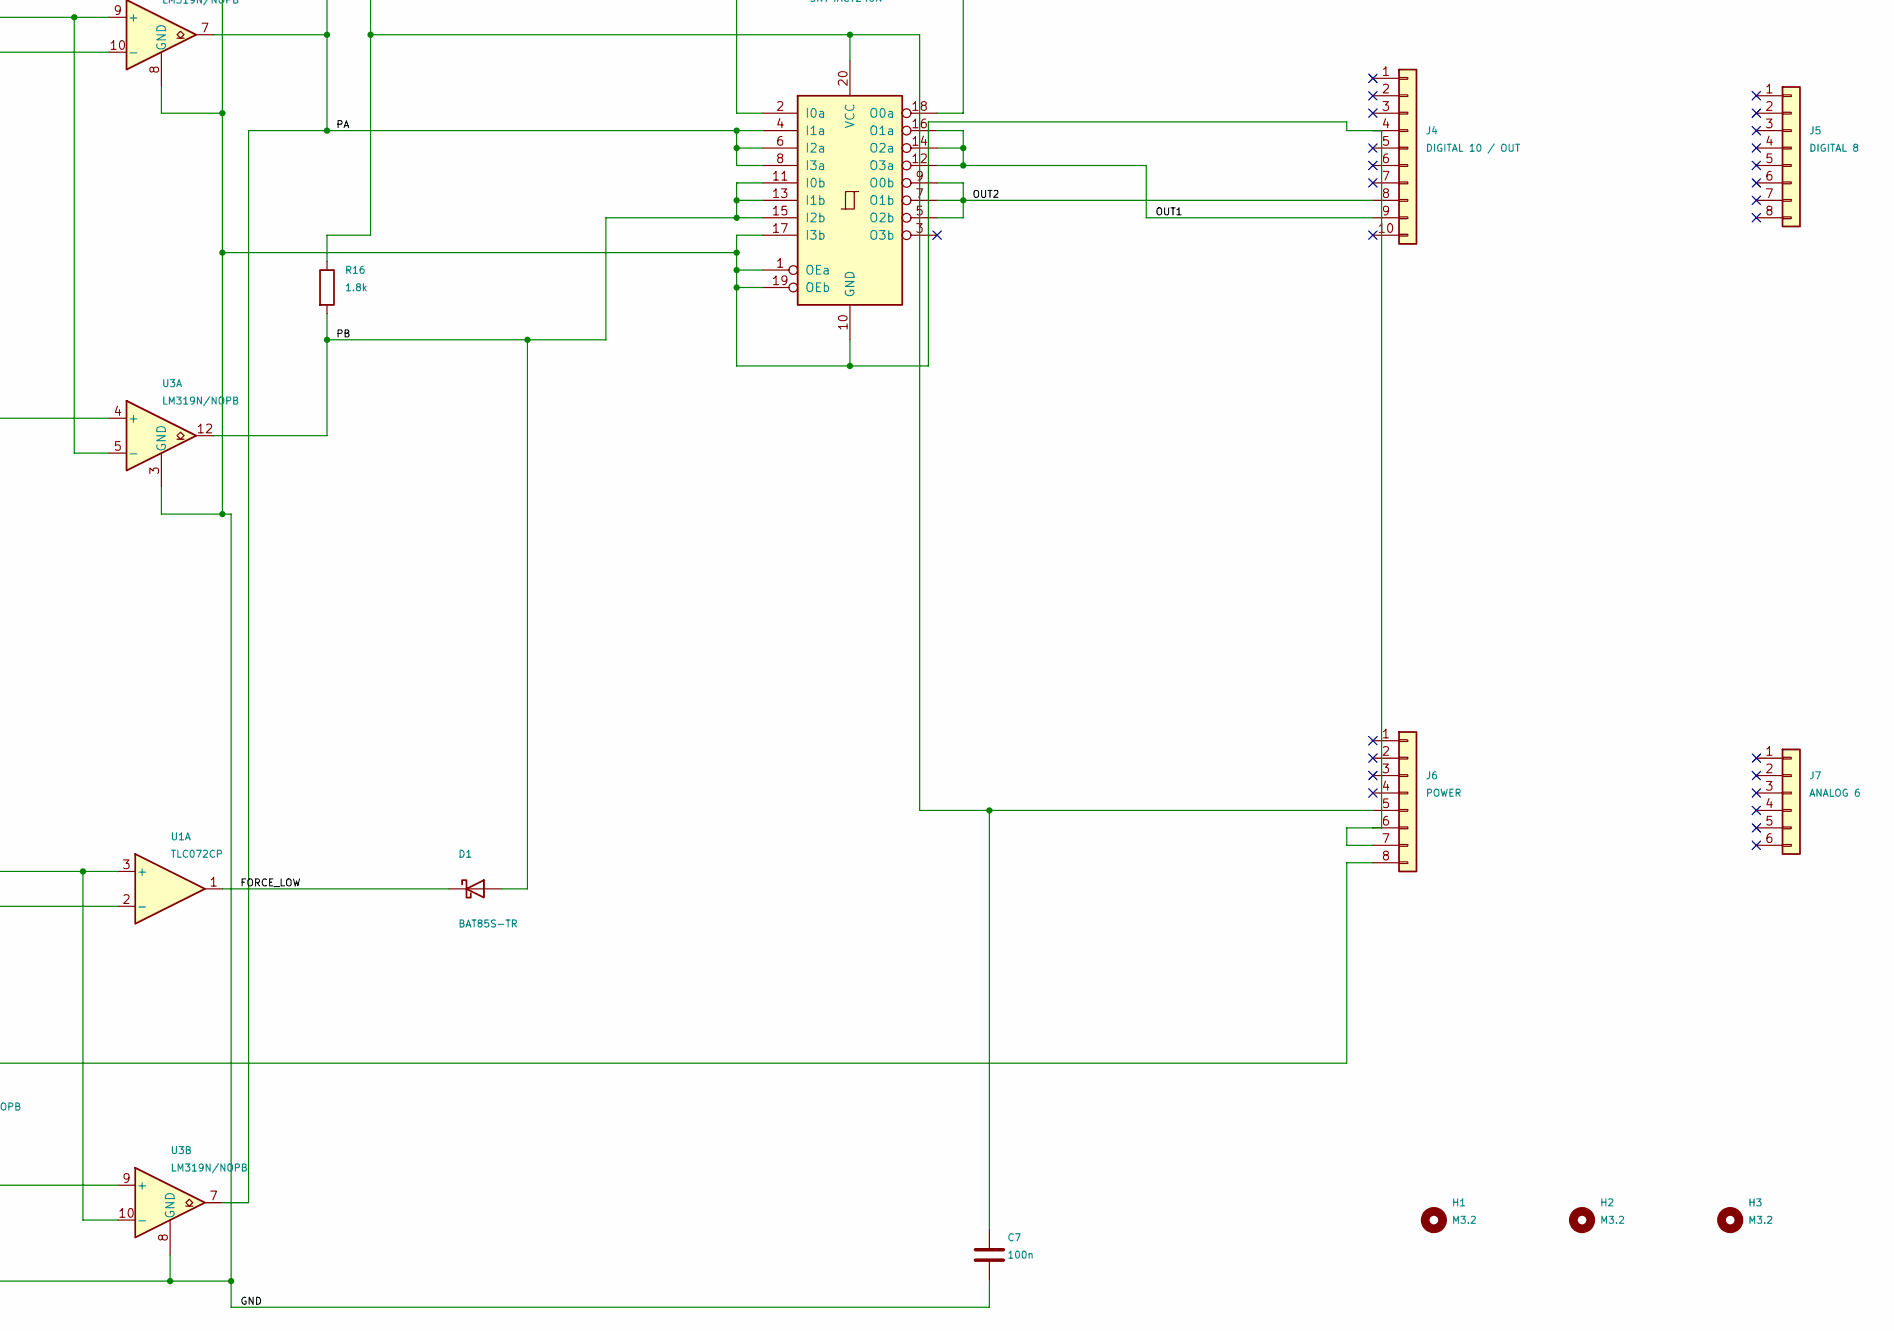
[picture p13: schematic Analog_PWM.kicad_sch, Analog PWM generator, part in row 2, column 2]

Parts:
C1: 22u/16V; CP_Radial_D5.0mm_P2.00mm; MPN MCGPR16V226M5X11
C2: 4.7u/50V; CP_Radial_D5.0mm_P2.50mm; MPN EEU-FC1H4R7H
C3: 2.4n C0G 1%; C317_5.08mm; MPN C317C242F3G5TA
C4, C5, C6, C7: 100n; Vishay_K15_P2.5mm; MPN K104K15X7RF5TL2
D1: BAT85S-TR; D_DO-35_SOD27_P7.62mm_Horizontal; MPN BAT85S-TR
H1, H2, H3: M3.2; MountingHole_3.2mm
J1: 7-10V DC, CENTRE +; BarrelJack_CUI_PJ-102AH_Horizontal; MPN PJ-102AH
J2: EXTERNAL DUTY; Mueller_BU1420701236; MPN BU-1420701236
J3: MANUAL / EXTERNAL; PinSocket_1x03_P2.54mm_Vertical; MPN PPTC031LFBN-RC
J4: DIGITAL 10 / OUT; PinSocket_1x10_P2.54mm_Vertical; MPN PPTC101LFBN-RC
J5: DIGITAL 8; PinSocket_1x08_P2.54mm_Vertical; MPN PPTC081LFBN-RC
J6: POWER; PinSocket_1x08_P2.54mm_Vertical; MPN PPTC081LFBN-RC
J7: ANALOG 6; PinSocket_1x06_P2.54mm_Vertical; MPN PPTC061LFBN-RC
R1, R4: 105; R_Axial_DIN0207_L6.3mm_D2.5mm_P7.62mm_Horizontal; MPN MFR-25FBF52-105R
R2, R3: 9.76; R_Axial_DIN0204_L3.6mm_D1.6mm_P5.08mm_Horizontal; MPN MBA02040C9768FC100
R5: 12.3k; R_Axial_DIN0207_L6.3mm_D2.5mm_P7.62mm_Horizontal; MPN RNF14BTC12K3
R6, R10, R11, R13: 1k; R_Axial_DIN0207_L6.3mm_D2.5mm_P7.62mm_Horizontal; MPN MFR-25FBF52-1K
R7: 12k; R_Axial_DIN0207_L6.3mm_D2.5mm_P7.62mm_Horizontal; MPN MFR-25FBF52-12K
R8, R15, R16: 1.8k; R_Axial_DIN0207_L6.3mm_D2.5mm_P7.62mm_Horizontal; MPN MFR-25FBF52-1K8
R9: 9.76k; R_Axial_DIN0207_L6.3mm_D2.5mm_P7.62mm_Horizontal; MPN MFR-25FBF52-9K76
R12, R14: 60.4k; R_Axial_DIN0207_L6.3mm_D2.5mm_P7.62mm_Horizontal; MPN MFR-25FRF52-60K4
RV1: 1k DUTY; Bourns_PTV09A2_20mm; MPN PTV09A-2020F-B102
RV2: 50k FREQ; Bourns_PTV09A2; MPN PTV09A-2015F-B503
RV3: Dual 1k DEAD TIME; SameSky_PTN16_A_Dual; MPN PTN16-A01220K1B2
U1: TLC072CP; DIP-8_W7.62mm; MPN TLC072CP
U2, U3: LM319N/NOPB; DIP-14_W7.62mm; MPN LM319N/NOPB
U4: LF50ABV; TO-220-3_Vertical; MPN LF50ABV
U5: SN74ACT240N; DIP-20_W7.62mm; MPN SN74ACT240N

Connections:
/CLOCK: R5.1, R7.1, U5.18 (O0a)
/CMD: R9.2, R10.2, R11.1, R13.1, U1.3 (+), U3.10 (-)
/COMMAND: J3.2, R9.1
/DT_HIGH: R14.1, RV3.5
/DT_LOW: R12.1, RV3.2
/END_HIGH: R1.2, R2.1, U3.9 (+)
/END_LOW: R3.2, R4.1, U1.2 (-)
/EXTERNAL: J2.1 (In), J3.3
/FORCE_LOW: D1.1 (K), U1.1
/FREQ_TOP: R5.2, RV2.3
/GND: C1.2, C2.2, C4.2, C5.2, C6.2, C7.2, J1.3, J2.2 (Ext), J4.4, J6.6, J6.7, R4.2, RV1.1, RV3.3, U1.4 (V-), U2.3 (GND), U2.6 (V-), U2.8 (GND), U3.3 (GND), U3.6 (V-), U3.8 (GND), U4.2 (GND), U5.1 (OEa), U5.10 (GND), U5.17 (I3b), U5.19 (OEb)
/HIGH: R13.2, R14.2, U3.4 (+)
/HYST: R6.2, R7.2, U2.5 (-)
/INT_SUM: C3.1, RV2.1, RV2.2, U1.6 (-)
/LOW: R11.2, R12.2, U2.10 (-)
/MANUAL: J3.1, RV1.2
/OSC: R8.2, U2.12, U5.2 (I0a)
/OUT1: J4.9, U5.12 (O3a), U5.14 (O2a), U5.16 (O1a)
/OUT2: J4.8, U5.5 (O2b), U5.7 (O1b), U5.9 (O0b)
/PA: R15.2, U2.7, U3.7, U5.4 (I1a), U5.6 (I2a), U5.8 (I3a)
/PB: D1.2 (A), R16.2, U3.12, U5.11 (I0b), U5.13 (I1b), U5.15 (I2b)
/TRI: C3.2, R6.1, U1.7, U2.9 (+), U3.5 (-)
/V5: C2.1, C4.1, C7.1, J6.5, R1.1, R8.1, R15.1, R16.1, RV1.3, RV3.6, U1.8 (V+), U4.3 (VO), U5.20 (VCC)
/VIN: C1.1, C5.1, C6.1, J1.1, J6.8, U2.11 (V+), U3.11 (V+), U4.1 (VI)
/VM: R2.2, R3.1, R10.1, RV3.1, RV3.4, U1.5 (+), U2.4 (+)

Notes on the sheet:
ANALOG PWM GENERATOR - COMPLETE CONNECTED CIRCUIT
Amani Mouaad / Cheiffou Melissa
RV1 DUTY | RV2 FREQUENCY | RV3 DEAD TIME (ONE DUAL-GANG PART)
J3: 1-2 manual / 2-3 SMA. J4: pin 9 OUT1, pin 8 OUT2, pin 4 GND.
Crossing wires connect only at a junction dot.

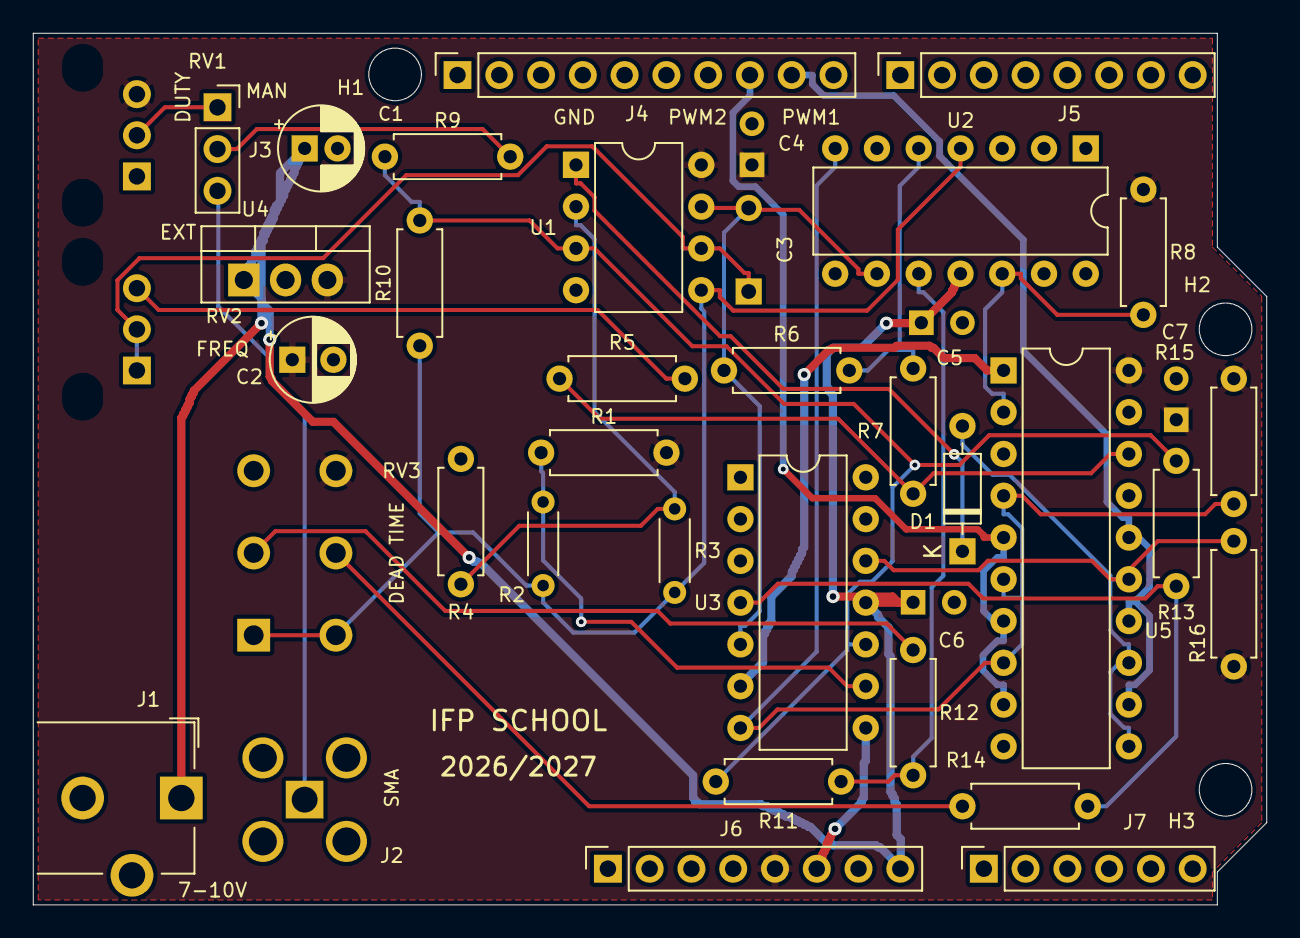
[picture p14: board Analog_PWM.kicad_pcb from above]

Board: 2 copper layers, 75.0 x 53.0 mm, 42 parts (0 on the bottom side), 25 nets.
