MouaadO/analog-pwm-generator/(commit log)

2026-10-13 Add reviewed PWM circuit, component models and documentation
2026-10-21 Add complete KiCad PWM PCB project and board previews
2026-11-05 Remove non-LTspice optional capacitors and refresh PCB views
2026-11-05 Clean PCB annotations and align connector references
2026-11-05 Remove buck PCB mounting holes and refresh fabrication files
